FelipeLenschow/ImageProjector/docs/preview_sunburst.png

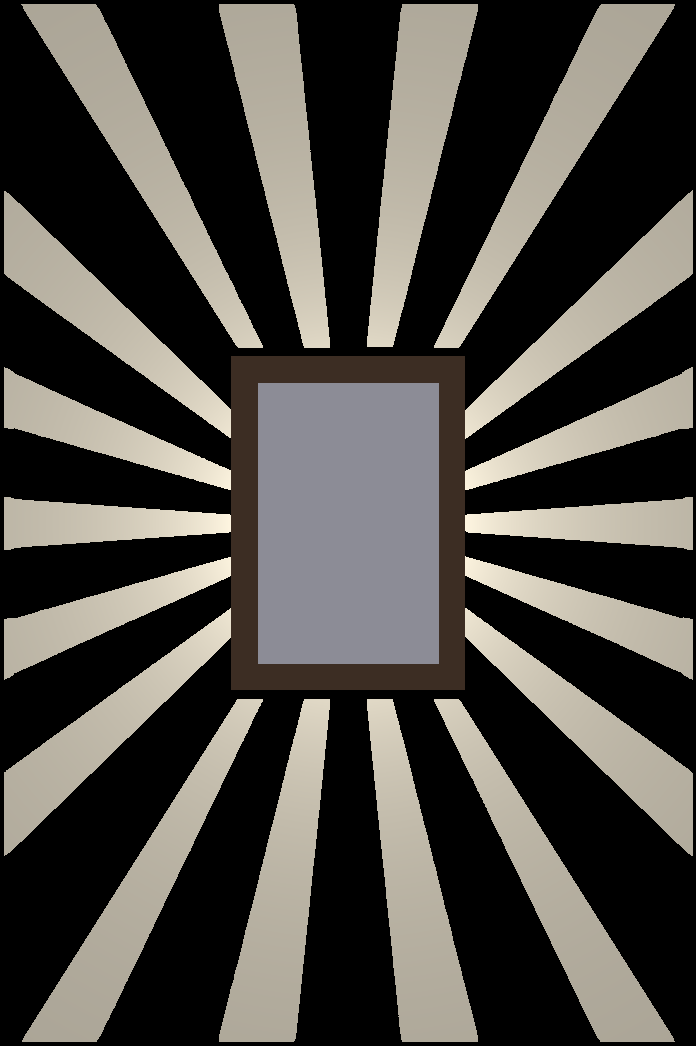
docs/preview_sunburst.png
