FelipeLenschow/ImageProjector/docs/target_sunburst.png

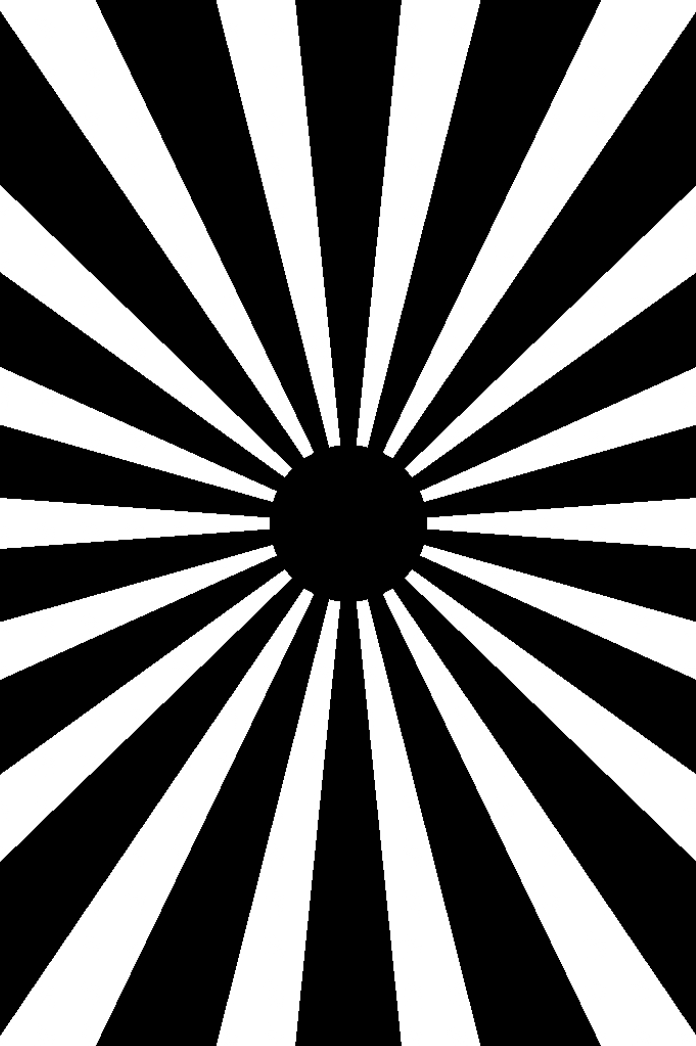
docs/target_sunburst.png
