FelipeLenschow/ImageProjector/examples/supra.jpg

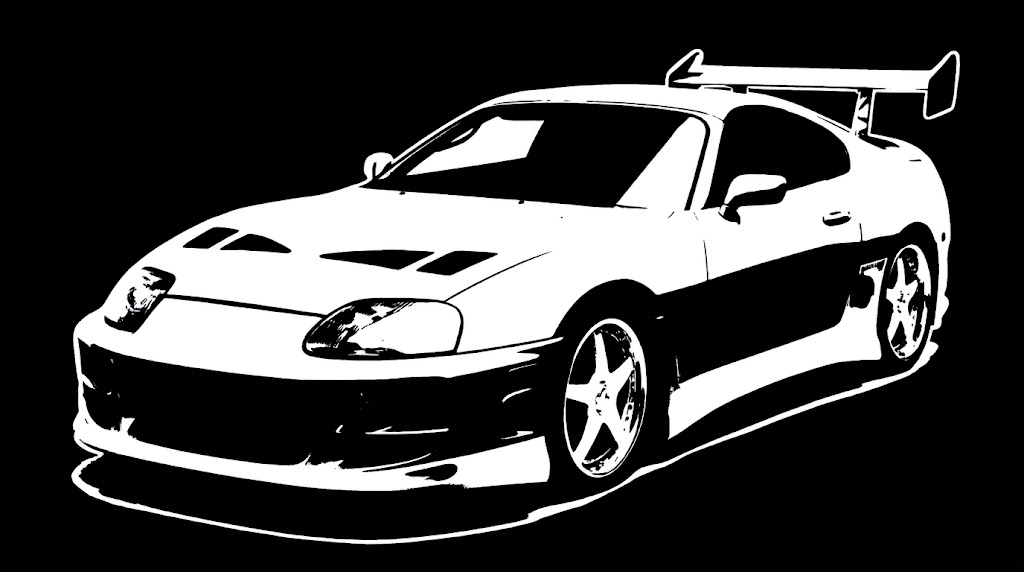
examples/supra.jpg
