FelipeLenschow/ImageProjector/stl/supra/assembly.stl

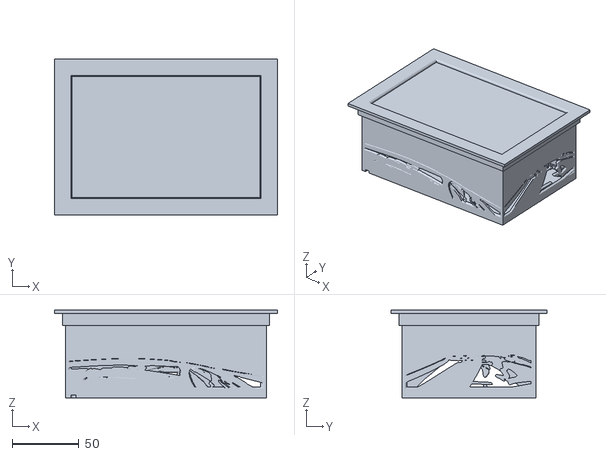
[picture p5: CAD file, 2026-11-02]
stl/supra/assembly.stl
166.5 x 116.5 x 65.4
