FelipeLenschow/ImageProjector/stl/supra/wall_top.stl

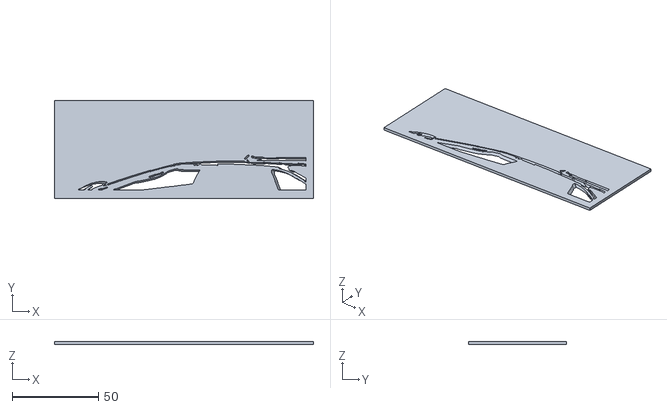
[picture p6: CAD file, 2026-11-02]
stl/supra/wall_top.stl
150.0 x 57.0 x 1.60
