FelipeLenschow/ImageProjector/stl/supra/wall_bottom.stl

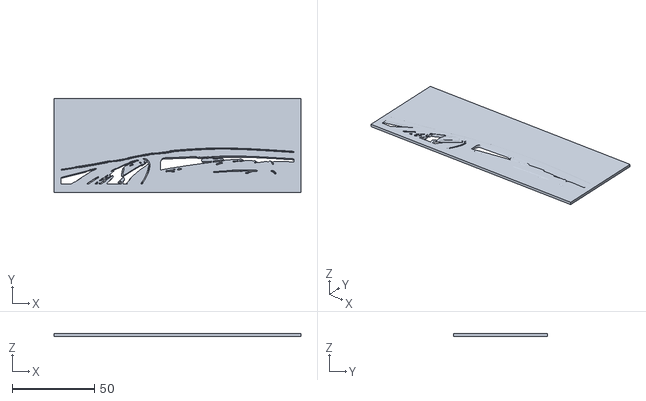
[picture p7: CAD file, 2026-11-02]
stl/supra/wall_bottom.stl
150.0 x 57.0 x 1.60
