FelipeLenschow/ImageProjector/stl/supra/wall_left.stl

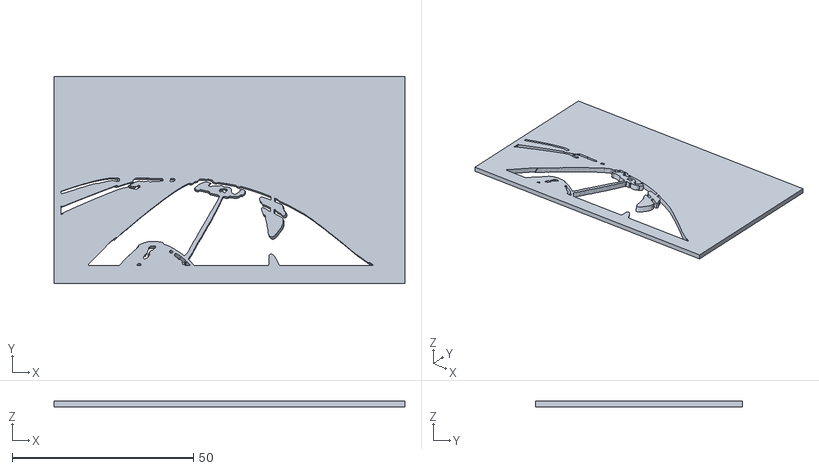
[picture p8: CAD file, 2026-11-02]
stl/supra/wall_left.stl
96.7 x 57.0 x 1.60
