FelipeLenschow/ImageProjector/stl/supra/wall_right.stl

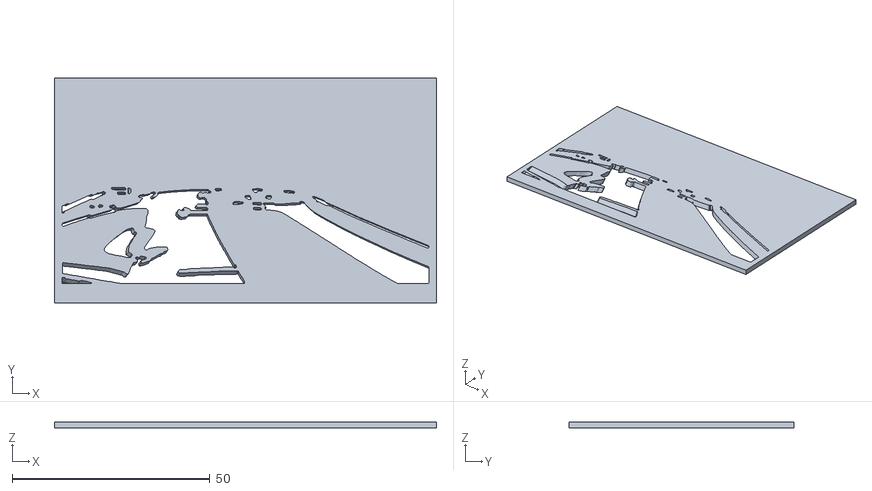
[picture p9: CAD file, 2026-11-02]
stl/supra/wall_right.stl
96.7 x 57.0 x 1.60
