FelipeLenschow/ImageProjector/stl/supra/back.stl

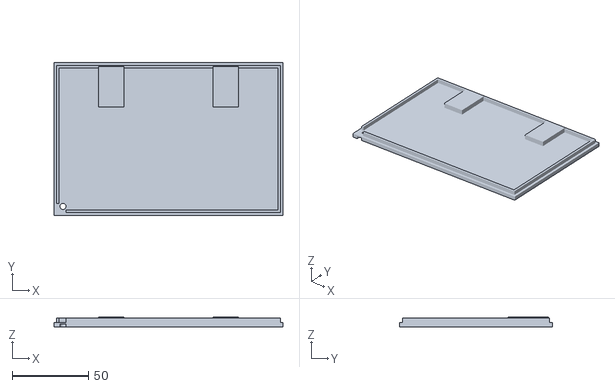
[picture p10: CAD file, 2026-11-02]
stl/supra/back.stl
150.0 x 100.0 x 6.60
