FelipeLenschow/ImageProjector/stl/supra/backer.stl

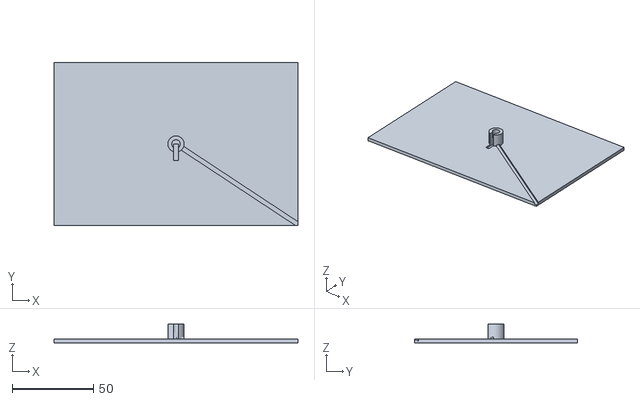
[picture p11: CAD file, 2026-11-02]
stl/supra/backer.stl
150.0 x 100.0 x 11.4
