FelipeLenschow/ImageProjector/stl/supra/bezel.stl

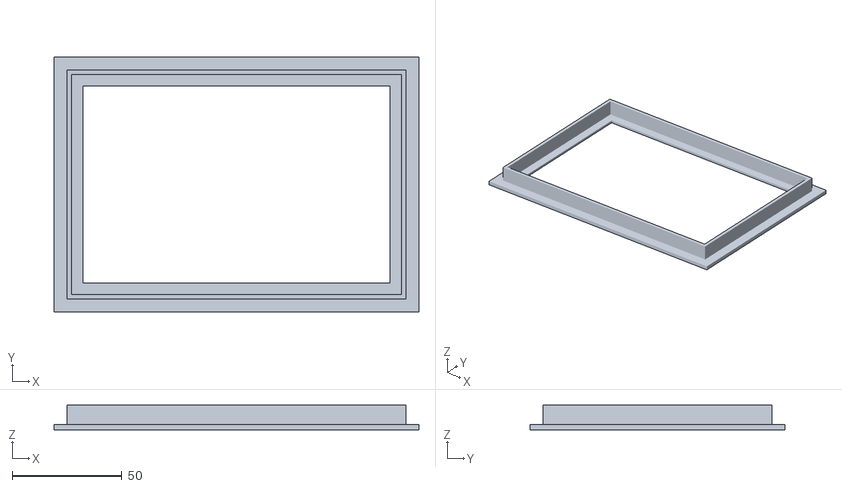
[picture p12: CAD file, 2026-11-02]
stl/supra/bezel.stl
166.5 x 116.5 x 11.4
