FelipeLenschow/ImageProjector/(commit log)

2026-11-02 Add projector picture frame STL generator
    Generates a wall-hung picture frame with an LED in the centre and
    perforated side walls. Holes are placed by ray tracing so the light
    projects an image onto the wall around the frame. Outputs body, backer
    (LED post) and bezel STLs plus a simulated projection preview.
    Claude-Session: https://claude.ai/code/session_01Ecy46gqUVjyQGRcUyMFA1Q
2026-11-02 Add car-themed projector frame design
    examples/car_frame.py draws a sports-car silhouette laid out in wall
    millimetres (car above the frame, reflection below, speed lines on the
    sides) and builds a landscape frame tuned for it. Ready-made STLs are
    in stl/car/.
    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
    [assembly.stl, backer.stl, bezel.stl, body.stl]
2026-11-02 Continuous stencil panels instead of dot grid; walls print flat
    The image is now cut out of the side walls as continuous ray-traced
    shapes, so the projection matches the original image instead of being
    made of dots. Each side wall is a separate panel printed flat; dark
    islands get one short bridge each. The back plate gets an alignment lip
    and the LED wire now runs down an inside corner so it casts no shadow.
    Car example and STLs regenerated.
    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
    [assembly.stl, back.stl, backer.stl, body.stl, wall_bottom.stl, wall_left.stl, wall_right.stl, wall_top.stl]
2026-11-02 Supra design: one big car centred on the frame
    Use the provided Supra stencil art as one large car centred on the frame,
    replacing the drawn car. Bridges now stop at the first dark edge, tiny
    dark specks are opened instead of bridged, and thin lines are widened to
    the printable minimum instead of dropped, so fine outlines survive.
    Preview uses an exact even-odd fill and clearer shading.
    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
    [assembly.stl, back.stl, backer.stl, bezel.stl, wall_bottom.stl, wall_left.stl, wall_right.stl, wall_top.stl]
2026-11-02 Add browser GUI to place and resize the picture around the frame
    The designer serves a local page where the picture can be dragged, zoomed
    and thresholded over the lit wall area, with live dimming of unlit areas
    and corner seams. It runs the real stencil preview and builds the STLs
    (saved to gui_out/ and offered as a zip). projector_frame gains
    generate(), lit_area() and compose_wall_image() so the GUI and the car
    example share the pipeline.
    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
